yinyuji299-prog/ultrasonic-wind-monitor/docs/images/模拟板.jpg

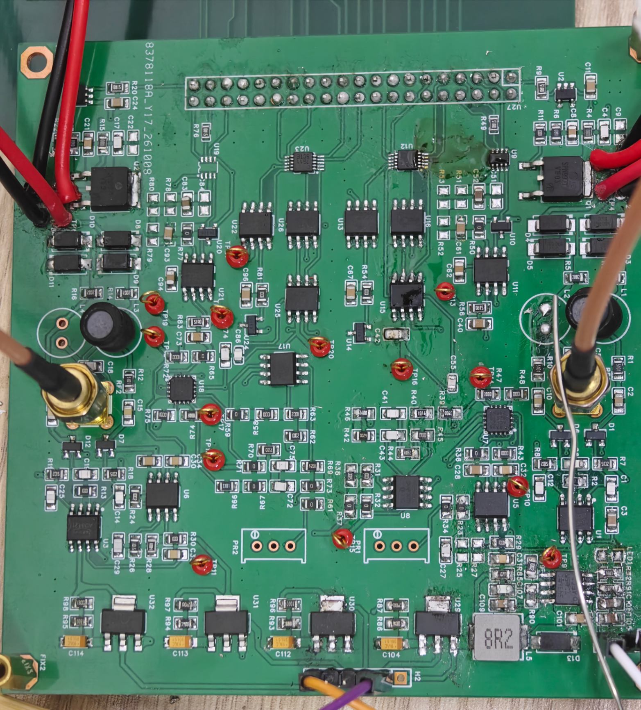
docs/images/模拟板.jpg
