yinyuji299-prog/ultrasonic-wind-monitor/docs/images/整机与串口屏.jpg

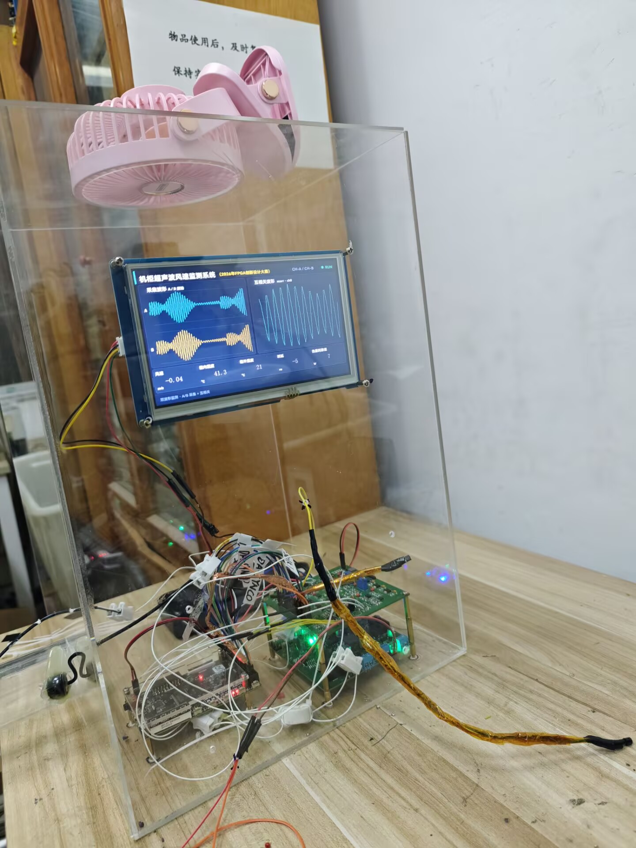
docs/images/整机与串口屏.jpg
