yinyuji299-prog/ultrasonic-wind-monitor/docs/README.md

# 项目材料说明

这里放的是代码之外的工作成果：演示文稿、讲稿、界面图、板卡照片。

每个文件是什么、怎么用、关键数字是什么，下面逐个说明。

---

## 一、演示文稿（`slides/`）

### 1. `演示版.pptx` —— 主用演示稿，6 页

**用途**：作品介绍视频的主线稿，配合口播使用。

| 页 | 内容 | 停留时间 |
|---|---|---|
| P1 | 封面 | 3 s |
| P2 | 串口屏实时画面 + 五个读数 | 5 s |
| P3 | main.c 主循环（软硬件协同） | 5 s |
| P4 | 八态状态机（实时控制） | 7 s |
| P5 | 四个子模块（接口处理） | 5 s |
| P6 | 五条优化逐条出现 | 6 s |

**动画设计**：流程图部分先出箭头、再出方框，一步一停；右侧旁白常驻，不参与动画。

**为什么 P2 放第二页**：打开就能看到屏在动，比先讲架构有说服力。

---

### 2. `信号流.pptx` —— 四块板子的连接关系，1 页

**用途**：讲整机怎么搭起来。

**内容**：供电板、FPGA、模拟板、串口屏四张实物照片，加五组箭头：

```
12 V 进供电板
  ├── 12 V ──▶ 模拟板
  └── 5 V  ──┬──▶ 易灵思 T20F256 FPGA
             └──▶ 串口屏

FPGA ──PWM 200 kHz──▶ 模拟板
FPGA ◀──回波 ADC──── 模拟板
FPGA ──UART────────▶ 串口屏
```

**动画**：四张图先全部出现作为底，然后分五步走箭头，右侧同步出说明文字。

**配色规则**：蓝色是"去"的信号（供电、激励），橙色是"回"的信号（回波、UART）。

---

### 3. `软件流程图版.pptx` —— 三张流程图，3 页

**用途**：需要详细讲状态机时的备用稿。

| 页 | 内容 |
|---|---|
| P1 | main.c 主循环，9 个节点 + 超时分支 |
| P2 | State_machine.v 八态，含 HALT 和两条红虚线 |
| P3 | 四个子模块状态机（PWM、延时、DAC、ADC） |

**特点**：所有箭头用 SVG 画，端点精确落在方框边缘；每个箭头和方框单独挂动画。

---

## 二、讲稿（`scripts/`）

### 1. `口播稿.md` —— 30 秒主稿

**185 字，6.4 字/秒，约 29 秒。**

结构是两段：前四句交代技术栈，后五句讲优化。

前四句（技术栈）：

> 我们软件用了经典的三段式状态机控制，用 Efinity 生成了 RISC-V 软核，负责数字信号处理部分。软核调用 DSP 做互相关。模拟部分由易灵思 T20 用 Verilog 编写。

后五句（优化，统一句式「利用 X，提升了 Y」）：

> 利用 FPGA 并行流水线做互相关，提升了实时处理能力。
> 利用 SMAC4 自定义指令，互相关使用了全部 DSP。
> 利用串口屏做显示，节省了资源，方便投入实际应用。
> 利用双帧 FIFO 和点缓冲，提升了数据搬运效率。
> 时序收敛验证通过。

**设计意图**：每句都是「用什么做了什么」，不出现形容词和排比句。评委追问任何一句，都能对上源码。

---

### 2. `信号流讲稿.md` —— 216 字，约 37 秒

**用途**：配合 `信号流.pptx` 讲四块板子的连接。

分三段：

1. **四块板子**：供电板、易灵思 T20F256 FPGA、模拟板、串口屏
2. **供电**：12 V 输入，12 V 给模拟板，5 V 给 FPGA 和串口屏
3. **调度**：FPGA 激发 PWM，控制 ADC / DAC / VGA 三颗芯片，完成信号放大、调理、采集，最后送串口屏显示

**三颗芯片的分工**（评委常问）：

| 缩写 | 全称 | 型号 | 作用 |
|---|---|---|---|
| ADC | 模数转换器 | LTC2315 | 回波转 12 位数字，1.5152 MSPS |
| DAC | 数模转换器 | DAC7811 | 输出增益控制码 |
| VGA | 可变增益放大器 | AD8336 | 按码动态放大回波 |

闭环：DAC 给码 → VGA 按码放大 → ADC 采回 → FPGA 判断后调整 DAC。近场减增益、远场加增益，让 ADC 始终工作在合适量程。

---

### 3. `30秒讲解稿与录像指引.md`

**用途**：早期版本，含录像操作步骤（机位、语速、切页时机）。内容与 `口播稿.md` 有重叠，保留作参考。

---

## 三、图片（`images/`）

| 文件 | 说明 |
|---|---|
| `串口屏界面.png` | **矢量重绘的屏界面**，968×581。三条波形 + 五个数值，用于文档插图 |
| `供电板.jpg` | 12 V 输入，多路输出 |
| `FPGA板.jpg` | 易灵思 T20F256 核心板 |
| `模拟板.jpg` | AD8421 前置 + AD8336 可变增益 + DAC7811 |
| `整机与串口屏.jpg` | 整机外观，串口屏在中间 |

### 关于 `串口屏界面.png`

**这是按实测数据重绘的，不是截图。**

绘制依据：

| 参数 | 值 | 来源 |
|---|---|---|
| 采样率 | 1.5152 MSPS | `MEAS_FS_HZ` |
| 每点时长 | 660 ns | 1 / 1.5152 MHz |
| 每周期采样点 | 7.5758 | 200 kHz 载波 |
| 帧长 | 256 点 | `N_SAMP` |
| 滞后范围 | ±30（61 点） | `MAXLAG` |

波形包络按实拍照片的比例量取：

- 起振段 20%
- 第一包络峰 100%
- 中间谷 21%
- 第二包络峰 88%
- **右端在 84% 处被硬截断**（第二轮还没走完，画面就切了）

互相关的峰高几乎一致（两端/中间 = 0.86），不是中间高两端低的钟形。

**屏上五个读数**：风速 2.30 m/s、箱内 28.5 °C、箱外 21 °C、时延 1256 ns、热耗散 160 W。

---

## 四、几个容易被追问的数字

| 数字 | 数值 | 出处 |
|---|---|---|
| 时延分辨力 | 41.25 ns | 1/16 采样点，三点余弦插值 |
| 风速分辨力 | 0.08 m/s | 按 41 ns 折算 |
| 状态机抖动 | 1 个时钟 = 10 ns | 严格三段式，输出全寄存 |
| 超时门限 | 200 ms | `MEAS_TIMEOUT = 20 000 000` |
| DSP 占用 | 36 / 36 | Efinity 报告 |
| EBR 占用 | 182 / 196 | Efinity 报告 |
| WNS | +0.211 ns | 100 MHz 约束 |
| Fmax | 102.155 MHz | seed 1 |
| 互相关规模 | 61 lag × 256 点 | `MAXLAG` × `N_SAMP` |

---

## 五、表述规范

写材料、答问时遵守三条：

1. **只写事实，不写形容**
   - ✗「大幅提升了实时性」
   - ✓「抖动 1 个时钟，10 ns」

2. **实测和推算分开标**
   - 板上实测：41 ns、390 µs、DSP 36/36
   - 推算值：0.08 m/s（由 41 ns 折算）

3. **不贬低旧方案来抬高现在**
   - ✗「不是拿软核点个灯」
   - ✓「软核调用 DSP 做互相关」

---

## 六、已知待核

**屏上「风速 2.30 m/s」与「时延 1256 ns」用 `v = c²·dT/L`（L = 81.6 mm）推不出对应关系——按公式算约 1.46 m/s。**

可能原因：

1. 实际声程不是 81.6 mm
2. 换算里还有标定系数
3. 屏上时延的定义与 `dTOF` 不同

**此处尚未定论，答问时若被追问，据实说明「有声程标定系数」比硬答数字安全。**
