yinyuji299-prog/ultrasonic-wind-monitor/docs/scripts/信号流讲稿.md

# 信号流讲稿（四块板子 · 供电 · 调度）

**对应 PPT**：`信号流.pptx`
**字数**：236 字
**语速**：6.4 字/秒　约 **37 秒**

---

## 第一段　四块板子

**我们一共用了四块板子。**／

**供电板、易灵思 T20F256 FPGA、模拟板、串口屏。**／

---

## 第二段　供电

**供电板 12 伏输入，输出两路。**／

**12 伏给模拟板供电，／**
**5 伏给 FPGA 和串口屏。**／

---

## 第三段　FPGA 怎么调度

**FPGA 激发 PWM**，／
**控制 AD、DA、VGA 三个器件**：／
**ADC 用 LTC2315，模数转换器；／**
**DAC 用 DAC7811，数模转换器；／**
**VGA 用 AD8336，可变增益放大器。**／

**三颗芯片完成信号的放大、调理和采集**，／
**最后把数据显示在串口屏上。**／

---

## 纯文本（复制用）

我们一共用了四块板子：供电板、易灵思 T20F256 FPGA、模拟板、串口屏。

供电板 12 伏输入，输出两路：12 伏给模拟板供电，5 伏给 FPGA 和串口屏。

FPGA 激发 PWM，控制 AD、DA、VGA 三个器件：ADC 用 LTC2315，模数转换器；DAC 用 DAC7811，数模转换器；VGA 用 AD8336，可变增益放大器。

三颗芯片完成信号的放大、调理和采集，最后把数据显示在串口屏上。

---

## 三颗芯片各干什么

| 缩写 | 全称 | 型号 | 在系统里的作用 |
|---|---|---|---|
| **ADC** | 模数转换器 | LTC2315 | 把回波模拟量变成 12 位数字，1.5152 MSPS |
| **DAC** | 数模转换器 | DAC7811 | 输出增益控制码，调 VGA 的放大量 |
| **VGA** | 可变增益放大器 | AD8336 | 按 DAC 给的码，动态放大回波 |

**三者的闭环：DAC 给码 → VGA 按码放大 → ADC 采回数字量 → FPGA 判断后调整 DAC。**

---

## 三段对应页面三组动画

| 段 | 画面 |
|---|---|
| 一 | 四张图依次出现 + 右侧“一” |
| 二 | 12V 输入箭头 + 12V/5V 两路输出 + 右侧“二” |
| 三 | PWM 箭头 + 回波箭头 + UART 箭头 + 右侧“三” |

---

## 念的时候

1. **「四块板子」四个名字一个不能漏**
2. **「12 伏」「5 伏」各念两遍**——输入一次，输出一次
3. **三个缩写念全称，不要只说 ADC、DAC、VGA**：模数转换器、数模转换器、可变增益放大器
4. **「放大、调理、采集」三个动作分开念**，不要连成一串
5. **最后「显示在串口屏上」念完停一秒**
