yinyuji299-prog/ultrasonic-wind-monitor/docs/slides/信号流.pptx

四块板子怎么连

12 V 进来，12 V 给模拟板，5 V 给 FPGA 和串口屏

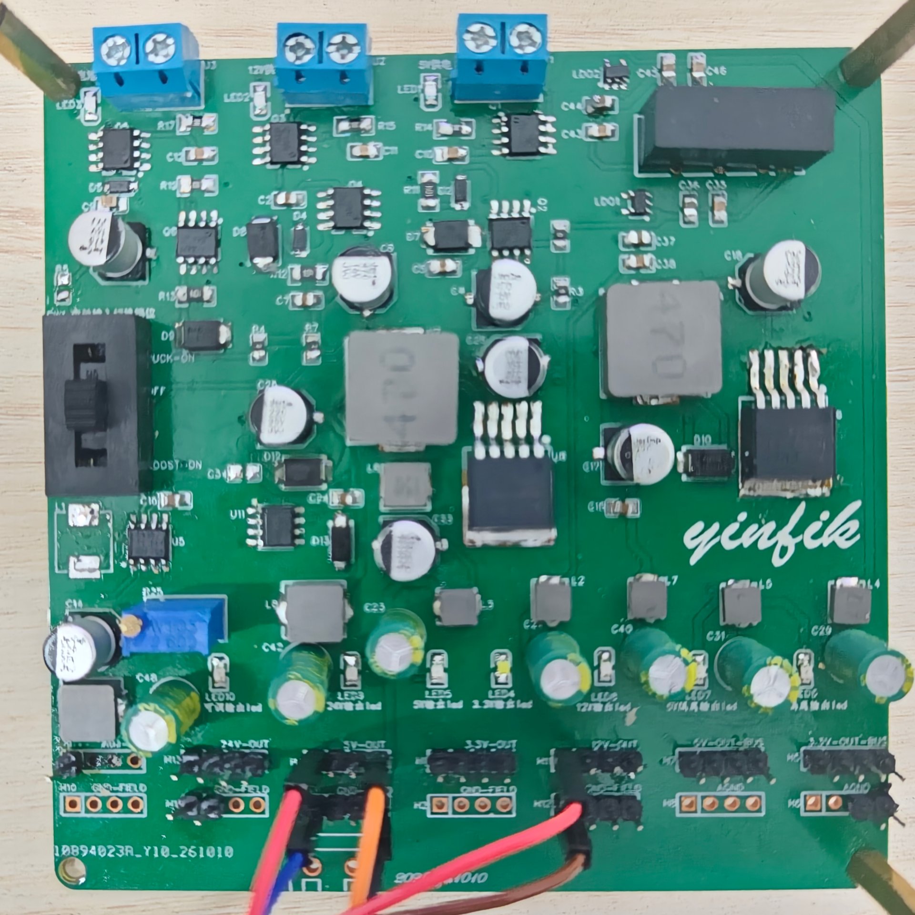
[picture p3: figure]

5 V

易灵思 T20F256 FPGA

PWM 200 kHz

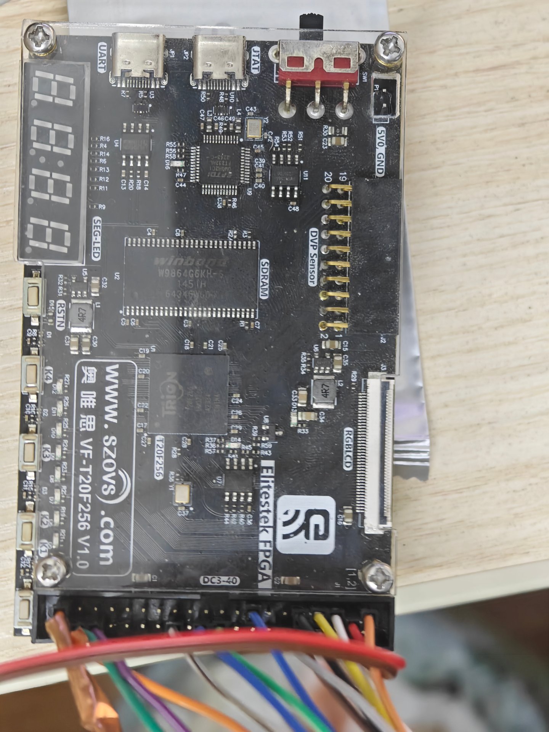
[picture p4: figure]

一

四块板子

供电板　·　易灵思 T20F256 FPGA
模拟板　·　串口屏

12 V

UART

二

供电板分三路

12 V 输入
12 V 出去，供模拟板
5 V 出去，供 FPGA 和串口屏

供电板

12 V 输入

回波 ADC

串口屏

800×480 · UART

三

FPGA 怎么调度

FPGA 激发 PWM，
控制 ADC（LTC2315 模数转换器）、
DAC（DAC7811 数模转换器）、
VGA（AD8336 可变增益放大器）；
完成信号放大、调理、采集，
最后送串口屏显示。

12 V

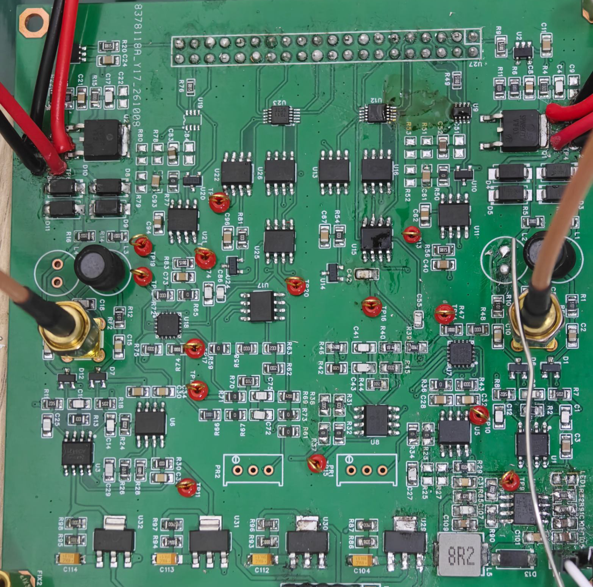
[picture p5: figure]

模拟板
