yinyuji299-prog/ultrasonic-wind-monitor/docs/slides/演示版.pptx

RISC-V + FPGA 异构架构

机柜超声波
风速监测系统

无转动部件　·　41 ns 时延分辨力
DSP 36/36 满载

Efinix Trion T20F256
100 MHz　·　WNS +0.211 ns
2026 全国大学生嵌入式芯片
与系统设计竞赛

## Slide 2

屏上实时画面

三条曲线 + 五个参数，1 Hz 刷新

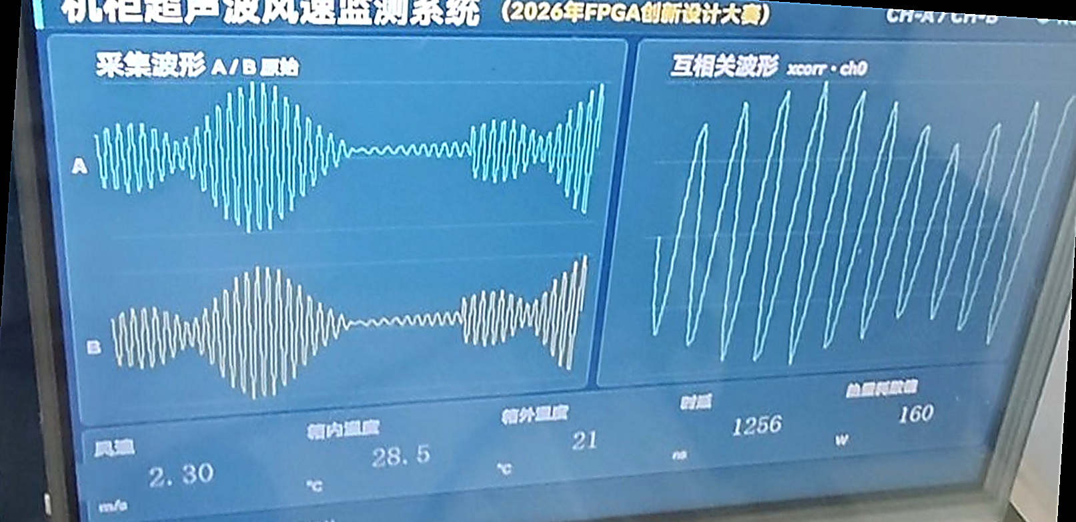
[picture p6: figure]

风速

2.30

m/s

加风后

箱内温度

28.5

°C

发热源加热后

箱外温度

21

°C

室温

时延

1256

ns

对应当前风速

热耗散

160

W

按公式换算

屏上 A 为当前回波，B 为存储回波，右上为互相关函数。

## Slide 3

软硬件协同　main.c 主循环

RISC-V 软核做数字信号处理，FPGA 做实时采集

开始

系统初始化（自检、屏握手）

main.c　4319 行

跑在 VexRiscv RV32IMC　100 MHz

dsp_frame() 每帧做四件事：

1　61 个 lag 里找最大峰
2　三点余弦插值，细化到 1/16 采样点
3　dTOF 换算风速：v = dTOF / 500
4　11 点中值 + 8 帧滑动平均

互相关 61 × 256 = 15616 次乘加，
由 3904 条 SMAC4 指令完成，不占软核周期。

写 FIFO_CTRL = 5（arm）

acq_bringup：零点标定

写 PWM_CTRL = 1（触发）

读 FIFO_STAT

dsp_frame（算 dTOF）

帧就绪？

否

置状态码 2

是

循环体：arm → 触发 → 读 → 算 → 滤波 → 回 arm

11 点中值 + 8 帧均值

超时恢复

## Slide 4

实时控制　State_machine.v 八态

严格三段式　·　一帧走一圈，每步只等一个 ack

IDLE

start_i（复位再拉起）

FIRE

start_i & ~gap_busy / start_i & arm

8 个状态，3 位编码

每个状态只等一个 ack 才往下跳

最坏抖动

1 个时钟 = 10 ns

超时门限 200 ms

软件写 MEAS_TIMEOUT = 20 000 000

任一状态超时即进 S_HALT，
PWM、ADC、DAC 同时关闭。

pwm_ack and start_delay1

WAIT

delay1_ack / fifo_arm

~gap_busy
& release_ready

ARM

fifo_arm_ack

ACQ

DRAIN

fifo_full && fifo_alm_full

acq_en = 1

GAP

1

read_all_done / fifo_release

timeout

S_HALT

1

one-hot 编码　·　每帧 390 µs

## Slide 5

接口处理　四个子模块状态机

Verilog 写在易灵思 T20 上，各自独立状态机

PWM_gen

in: start_pwm

start_pwm

cyc_cnt == 6

四个模块　各自只做一件事

PWM_gen
3 态　产 6 个 200 kHz 周期

Delay_gen
2 态　倒计数到 cnt_eff

DAC7811_Ctrl
3 态　16 位移位 + 间隔

LTC2315_Ctrl
5 态　SPI 时序，5 位 one-hot

主控只负责发起和等 ack，
模块内部怎么走，主控不管。

out: pwm_ack

IDLE

TX

ACK

start_delay

Delay_gen

in: start_delay

out: delay_ack

IDLE

COUNT

DAC7811_Ctrl

in: start_ADDA

start_ADDA

bit_cnt <= 15 / da_ack

out: da_ack

IDLE

SHIFT

GAP

enable

wait_cnt == 0

bit_cnt == 11

wait_cnt == 0

LTC2315_Ctrl

in: enable

out: samp_valid

IDLE

SETUP

SHIFT

HOLD

GAP

主控不关心它们内部怎么走，只看 ack 回没回来

## Slide 6

我们做了五个优化

每一条都是利用 FPGA 的资源特性换来的

FPGA 并行流水线

互相关

提升实时处理能力

SMAC4 自定义指令

一条指令四个乘加

互相关使用全部 DSP

串口屏做显示

命令由硬件生成

节省资源，便于落地

双帧 FIFO + 点缓冲

三条曲线串行发

提升数据搬运效率

时序收敛

100 MHz 约束

验证通过

一颗 T20F256　·　无外部 MCU　·　整机两颗芯片

06
