yinyuji299-prog/ultrasonic-wind-monitor/docs/scripts/30秒讲解稿与录像指引.md

# 30 秒讲解稿 + 录像指引

**PPT**：`PPT_30s\机柜超声波风速监测系统.pptx`（6 页）
**目标**：30 秒内讲完，评委听完能记住三个词——**软核、自定义指令、DSP 满载**

---

## 一、30 秒讲解稿

> **总字数 148 字，正常语速 30 秒。**
> `/` 短停 0.3 秒，`‖` 长停 1 秒，**粗体**重音。

### 第 1 页 · 封面（0:00–0:03，3 秒）

> 这是我们做的**机柜超声波风速监测系统**。／没有转动部件，用声波测风。

---

### 第 2 页 · 信号链（0:03–0:10，7 秒）

> 两枚换能器对射，风速改变声波的到达时间。／
> 但 1 米每秒的风，只让时间变 **0.7 纳秒**。‖
> 这个量级，**软件算不出来**，只能靠互相关。

---

### 第 3 页 · 软核（0:10–0:18，8 秒）

> 所以核心是一颗 **RISC-V 软核**，加 **35 条自定义指令**。／
> 硬件管定时——激励、采样、相关；／
> 软核管算法——取峰、滤波、标定。／**分工是划死的。**

---

### 第 4 页 · 硬件加速（0:18–0:24，6 秒）

> 互相关的乘法全部下沉到 DSP。／
> 芯片里的 **36 块 DSP，一块不剩，全用来做相关**。／
> 软核不做一次乘法，只发指令、取结果。

---

### 第 5 页 · 实测（0:24–0:28，4 秒）

> 板上实测：时延分辨力 **41 纳秒**，折成风速 **0.08 米每秒**。／都是实测，不是仿真。

---

### 第 6 页 · 收尾（0:28–0:30，2 秒）

> 一颗 T20，从声波到屏幕，全链路自主。／**谢谢。**

---

## 二、全稿连读版（贴提词器用）

```
这是我们做的机柜超声波风速监测系统。没有转动部件，用声波测风。

两枚换能器对射，风速改变声波的到达时间。但 1 米每秒的风，只让时间变 0.7 纳秒。这个量级，软件算不出来，只能靠互相关。

所以核心是一颗 RISC-V 软核，加 35 条自定义指令。硬件管定时——激励、采样、相关；软核管算法——取峰、滤波、标定。分工是划死的。

互相关的乘法全部下沉到 DSP。芯片里的 36 块 DSP，一块不剩，全用来做相关。软核不做一次乘法，只发指令、取结果。

板上实测：时延分辨力 41 纳秒，折成风速 0.08 米每秒。都是实测，不是仿真。

一颗 T20，从声波到屏幕，全链路自主。谢谢。
```

---

## 三、录像方案

### 方案 A：只录屏幕 + 配音（最省事，推荐）

**适用**：PPT 为主，不需要出镜。

| 步骤 | 操作 |
|---|---|
| 1 | PowerPoint 打开 PPT，按 **F5** 全屏放映 |
| 2 | 用 **OBS Studio** 或 Windows 自带 **Win+G** 录屏 |
| 3 | 录屏区域选**全屏 1920×1080**，帧率 30 |
| 4 | 一边放映翻页，一边念稿 |
| 5 | 导出 MP4，H.264，码率 8 Mbps |

**翻页节奏**（按稿子走，念到哪句翻哪页）：

| 时间 | 页 | 触发翻页的那句话 |
|---|---|---|
| 0:00 | 1 | 开始 |
| 0:03 | 2 | "两枚换能器对射" |
| 0:10 | 3 | "所以核心是一颗 RISC-V" |
| 0:18 | 4 | "互相关的乘法全部下沉" |
| 0:24 | 5 | "板上实测" |
| 0:28 | 6 | "一颗 T20" |

**声音**：用手机耳机麦或 USB 麦，别用笔记本内置麦（底噪大）。

---

### 方案 B：PPT + 实物画中画（更有说服力）

**适用**：想让人看到真机在跑。

**布局**：PPT 占主画面，右下角小窗放实物视频。

| 步骤 | 操作 |
|---|---|
| 1 | 先单独拍一段**实物特写**（屏上三波形 + 手加风），约 20 秒 |
| 2 | OBS 里加两个来源：**窗口捕获(PPT)** 铺满 + **媒体源(实物视频)** 缩到右下 1/4 |
| 3 | 念稿时，说到第 4 页（硬件加速）让实物视频开始播 |
| 4 | 导出 |

**实物视频拍法**（20 秒素材）：

```
0-5s   整机正面，屏上三波形在动
5-12s  手拿风扇/纸板对着风道口扇风
12-16s 屏特写：风速从 0.0x 涨到 2.x，时延跟着变
16-20s 撤风，数值回落
```

**注意**：拍之前**上电等 10 秒**，让模板采完，否则 s1 那条是平的。

---

### 方案 C：纯录屏 + 真人出镜（不推荐，30 秒太短来不及）

---

## 四、录制参数

| 项 | 建议值 |
|---|---|
| 分辨率 | **1920×1080** |
| 帧率 | 30 fps |
| 视频码率 | 8 Mbps |
| 音频 | 44.1 kHz，单声道，AAC 128 kbps |
| 容器 | MP4 (H.264) |
| 时长 | **严格 ≤ 30 秒**，多 2 秒都可能被判超时 |

---

## 五、三个容易翻车的点

**① 别念快**

**148 字 / 30 秒 = 4.9 字/秒，正好。** 但人一紧张会加速，念到 5.5 字/秒就只剩 27 秒，画面会空。

**对策**：先对着秒表念三遍，卡准节奏再录。

**② 数字要慢**

**"0.7 纳秒""41 纳秒""0.08 米每秒"——这三个数字是记忆点，每个都要停顿。**

**念快了评委记不住，等于白讲。**

**③ 别说"快多少倍"**

**CFU 的加速比没有干净对照数据。** 说"放进硬件"就够了，说倍数会被追问。

---

## 六、逐页要点速查（万一被追问）

| 页 | 一句话答 |
|---|---|
| 1 | 无转动部件，不怕沙尘结冰 |
| 2 | 1 m/s → 0.7 ns，必须用相关 |
| 3 | 35 条自定义指令，含 SMAC4 四乘加 |
| 4 | DSP 36/36 全给互相关，软核零乘法 |
| 5 | 41 ns 分辨力，0.08 m/s，板上实测 |
| 6 | 采集、处理、显示全在一颗芯片里 |
