yinyuji299-prog/ultrasonic-wind-monitor/docs/scripts/口播稿.md

# 口播稿

**PPT**：`演示版.pptx`
**字数**：185 字
**语速**：6.4 字/秒　约 **29 秒**

---

## 稿子

**我们软件用了经典的三段式状态机控制**，／
**用 Efinity 生成了 RISC-V 软核**，负责数字信号处理部分。／
**软核调用 DSP 做互相关**。／
**模拟部分由易灵思 T20 用 Verilog 编写**。／

**利用 FPGA 并行流水线做互相关，提升了实时处理能力。**／

**利用 SMAC4 自定义指令，互相关使用了全部 DSP。**／

**利用串口屏做显示，节省了资源，方便投入实际应用。**／

**利用双帧 FIFO 和点缓冲，提升了数据搬运效率。**／

**时序收敛验证通过。**／

---

## 纯文本（复制用）

我们软件用了经典的三段式状态机控制，用 Efinity 生成了 RISC-V 软核，负责数字信号处理部分。软核调用 DSP 做互相关。模拟部分由易灵思 T20 用 Verilog 编写。

利用 FPGA 并行流水线做互相关，提升了实时处理能力。

利用 SMAC4 自定义指令，互相关使用了全部 DSP。

利用串口屏做显示，节省了资源，方便投入实际应用。

利用双帧 FIFO 和点缓冲，提升了数据搬运效率。

时序收敛验证通过。

---

## 逐页对应

| 页 | 画面 | 口播 |
|---|---|---|
| P1 | 封面 | 三段式状态机 |
| P2 | 整机 + 读数 | 快速带过 |
| P3 | main.c 主循环 | 软核做数字信号处理 + 并行流水线 + 双帧 FIFO |
| P4 | 八态状态机 | 三段式状态机 + 时序收敛 |
| P5 | 四子模块 | Verilog 模拟部分 + 串口屏 |
| P6 | 五条优化逐条出现 | SMAC4 + 全部 DSP |

---

## 时长

| 段 | 字数 | 时长 |
|---|---|---|
| 技术栈 | 80 | 13s |
| 五条优化 | 105 | 16s |
| **合计** | **185** | **29s** |

---

## 念的时候

1. **前四句交代技术栈，一口气说完**
2. **五句「利用……提升了……」保持同样节奏**，不要忽快忽慢
3. **「全部 DSP」加重**
4. **「方便投入实际应用」不要吞成「方便应用」**
5. **最后一句「时序收敛验证通过」念完停一秒再停录**
