yinyuji299-prog/ultrasonic-wind-monitor/docs/images/串口屏界面.png

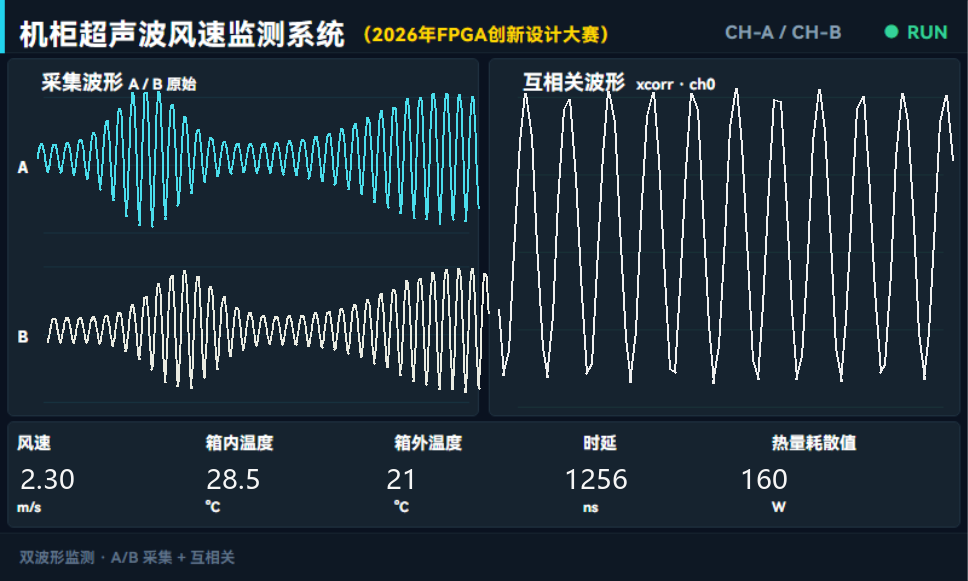
docs/images/串口屏界面.png
