yinyuji299-prog/ultrasonic-wind-monitor/(commit log)

2026-11-03 添加海报：机柜超声波风速监测系统
2026-11-04 合并代码与材料到同一仓库：src、embedded_sw、docs、海报
